buteomont/Delivery-Box-Reporter-LoRa/resources/Presentation/VL53L0X.jpg

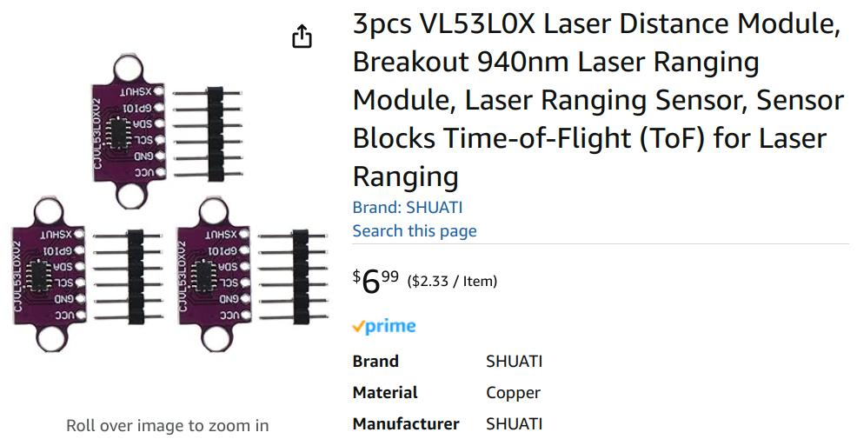
resources/Presentation/VL53L0X.jpg
