buteomont/Delivery-Box-Reporter-LoRa/resources/Presentation/TP4056 Battery Manager.png

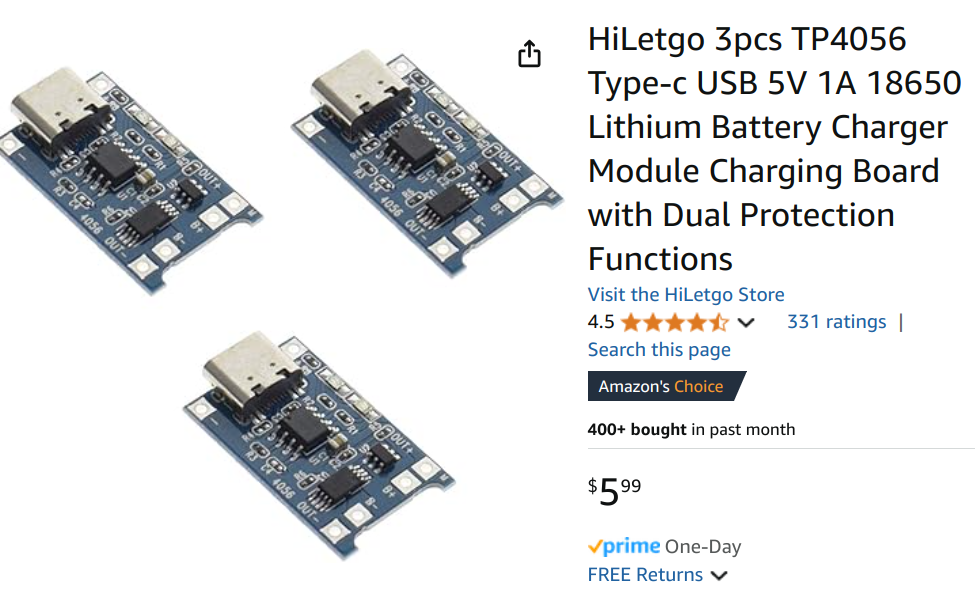
resources/Presentation/TP4056 Battery Manager.png
