buteomont/Delivery-Box-Reporter-LoRa/resources/Presentation/box in snow.png

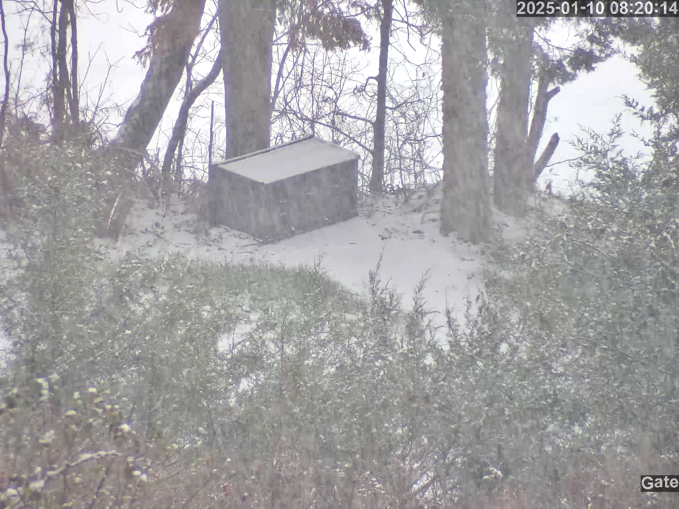
resources/Presentation/box in snow.png
