buteomont/Delivery-Box-Reporter-LoRa/resources/Presentation/display.jpg

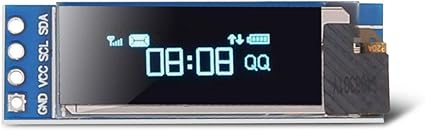
resources/Presentation/display.jpg
