buteomont/Delivery-Box-Reporter-LoRa/resources/Presentation/ESP-D1-Mini.jpg

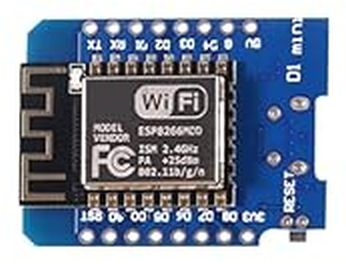
resources/Presentation/ESP-D1-Mini.jpg
