buteomont/Delivery-Box-Reporter-LoRa/resources/Presentation/HCSR04.png

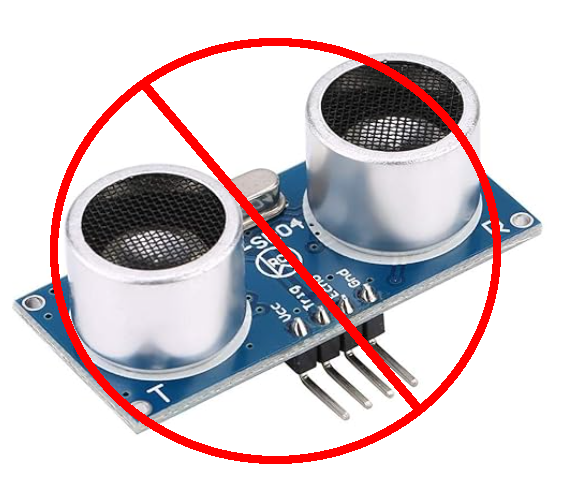
resources/Presentation/HCSR04.png
