buteomont/Delivery-Box-Reporter-LoRa/resources/Presentation/laser.jpg

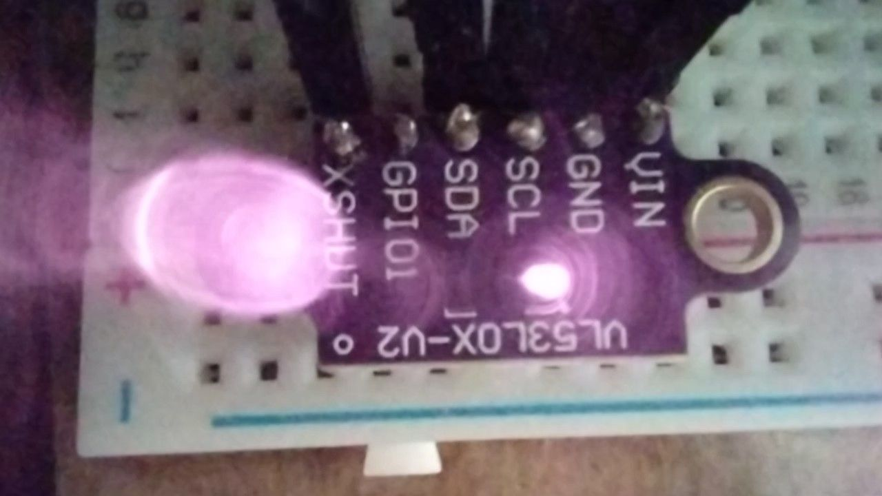
resources/Presentation/laser.jpg
