buteomont/Delivery-Box-Reporter-LoRa/resources/Presentation/LoRa to MQTT converter.png

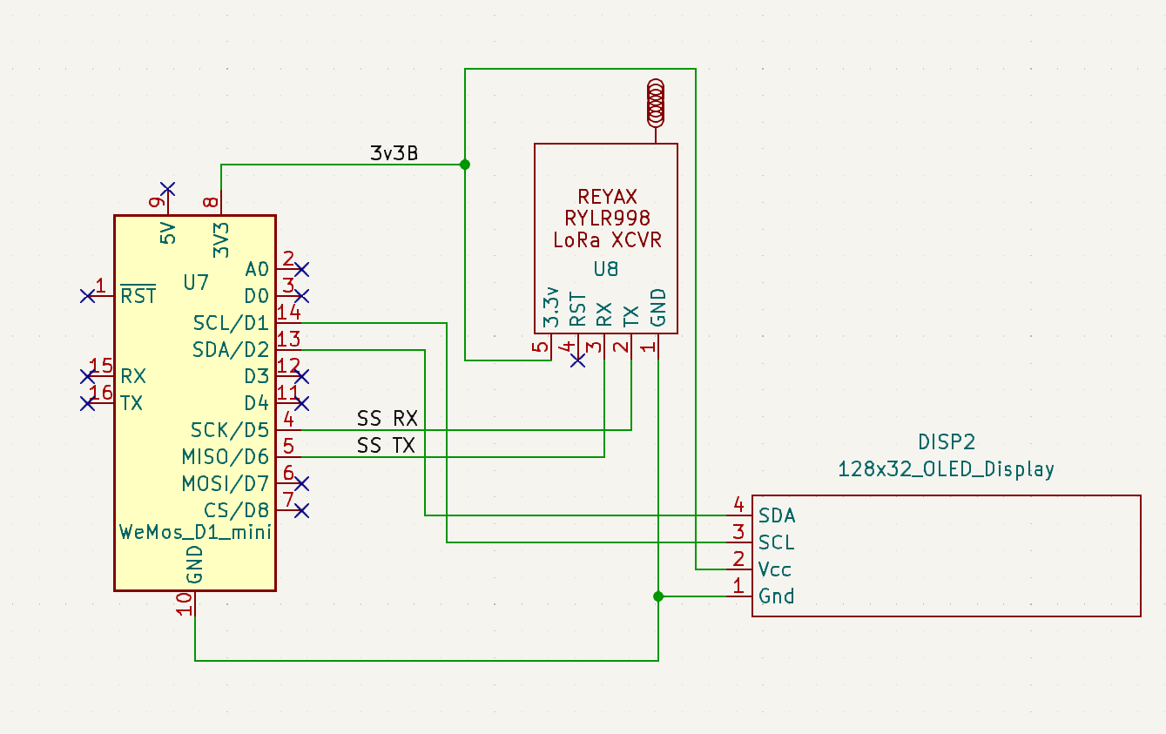
resources/Presentation/LoRa to MQTT converter.png
