buteomont/Delivery-Box-Reporter-LoRa/resources/Presentation/new water line view labelled.jpg

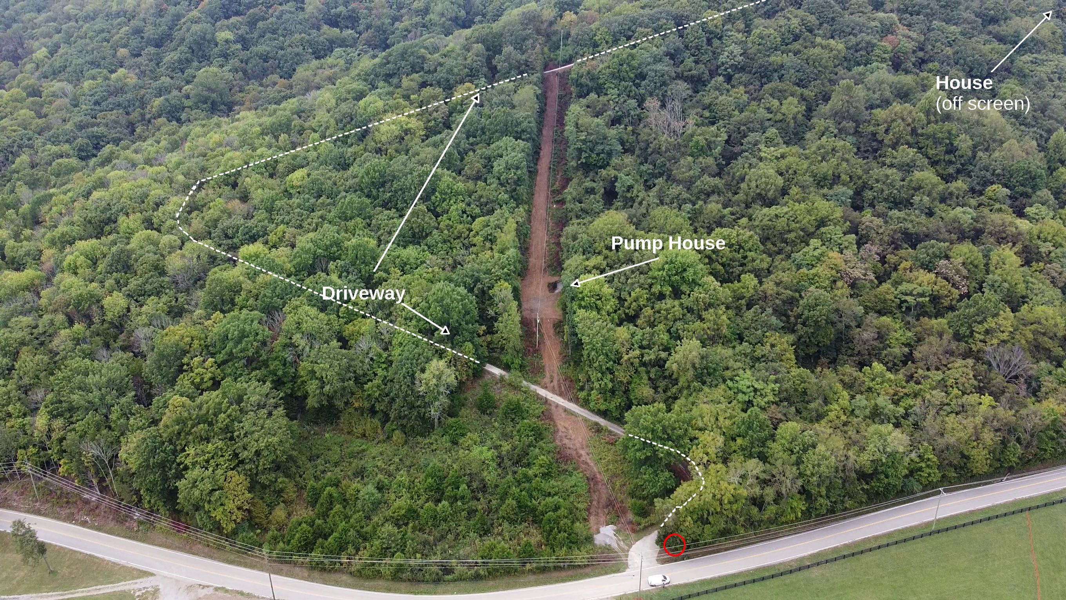
resources/Presentation/new water line view labelled.jpg
