buteomont/Delivery-Box-Reporter-LoRa/resources/Presentation/new water line view.jpg

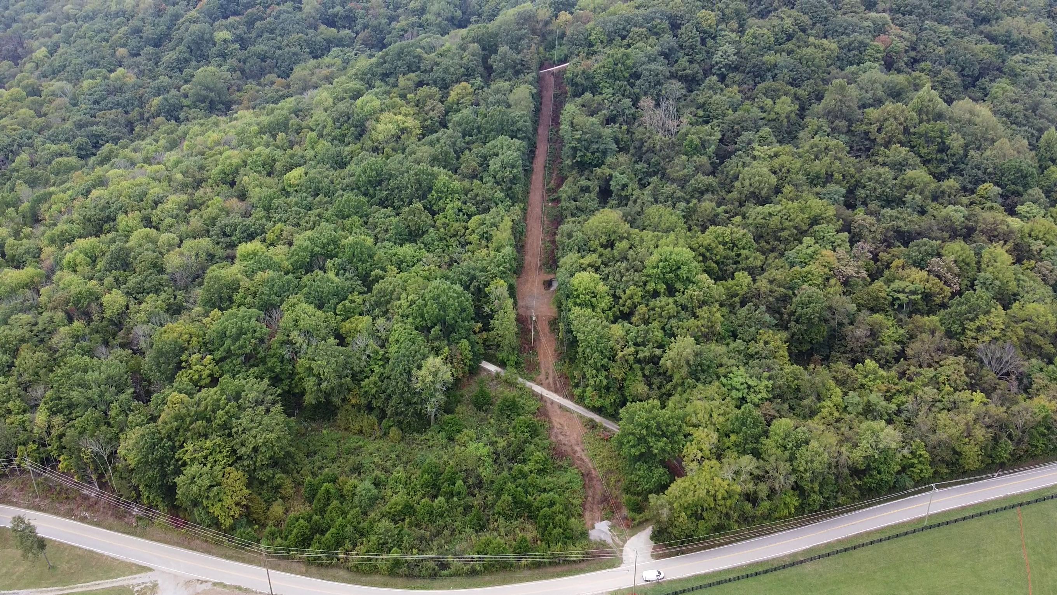
resources/Presentation/new water line view.jpg
