buteomont/Delivery-Box-Reporter-LoRa/resources/Presentation/pumphouse in snow.png

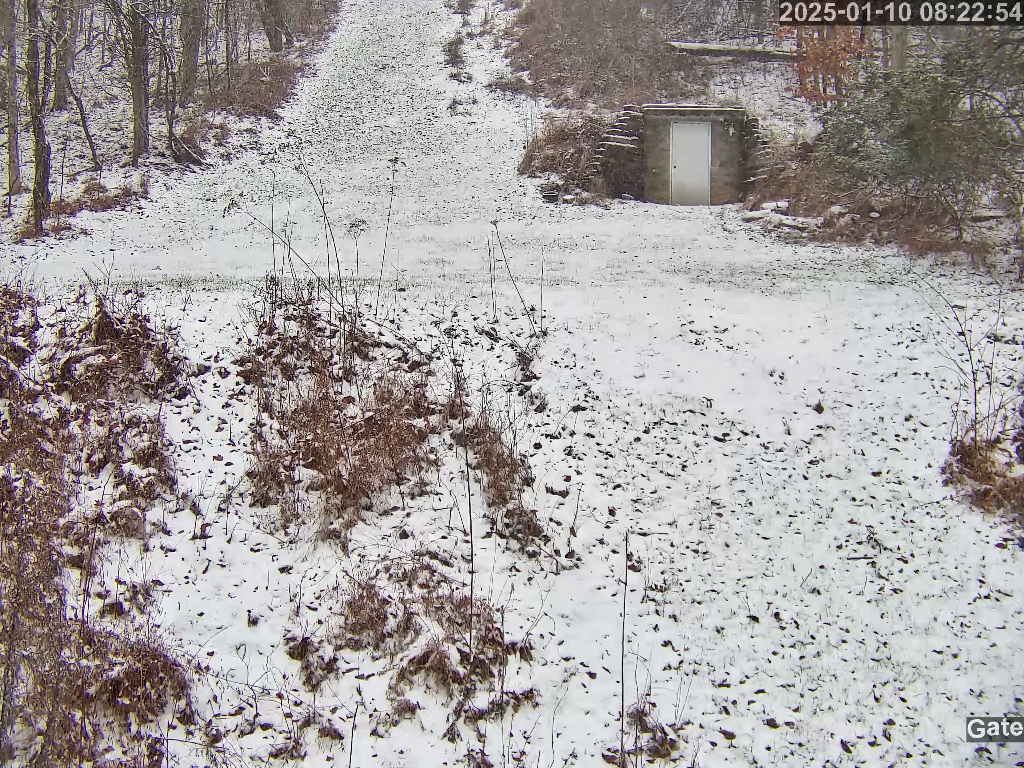
resources/Presentation/pumphouse in snow.png
