buteomont/Delivery-Box-Reporter-LoRa/resources/Presentation/receiver.jpg

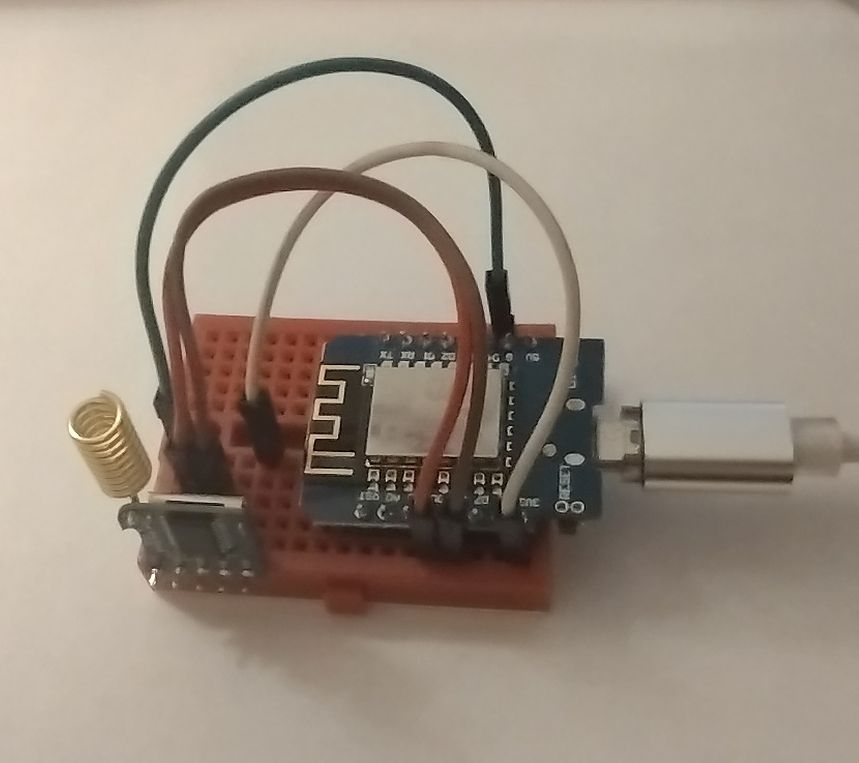
resources/Presentation/receiver.jpg
