buteomont/Delivery-Box-Reporter-LoRa/resources/Presentation/RYLR998.jpg

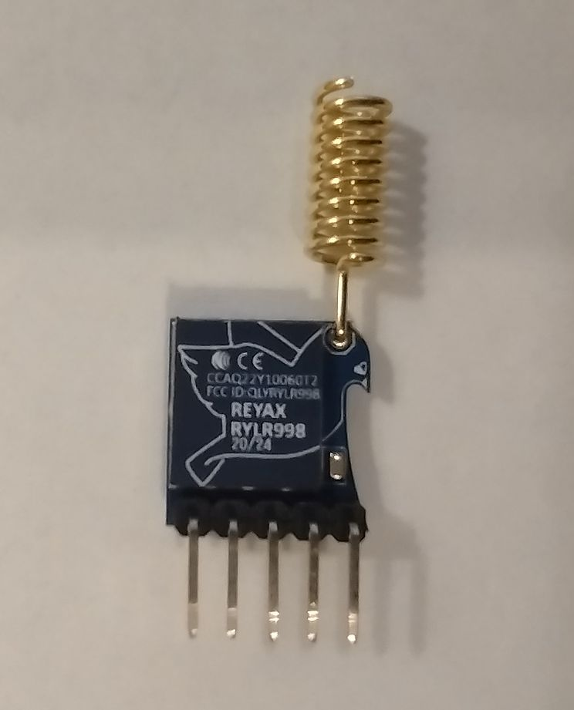
resources/Presentation/RYLR998.jpg
