buteomont/Delivery-Box-Reporter-LoRa/resources/Presentation/Schematic Full Sensor.png

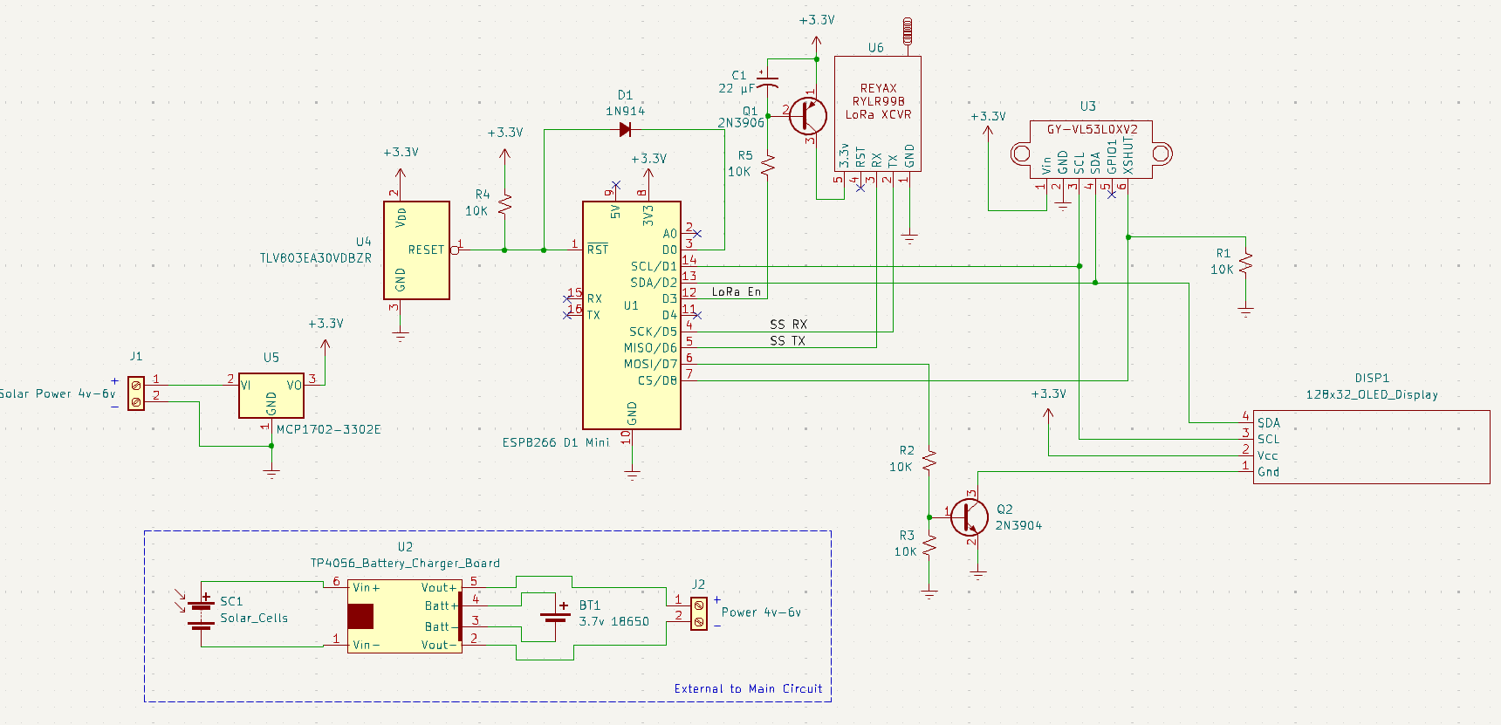
resources/Presentation/Schematic Full Sensor.png
