buteomont/Delivery-Box-Reporter-LoRa/resources/Presentation/Schematic Main zoom.png

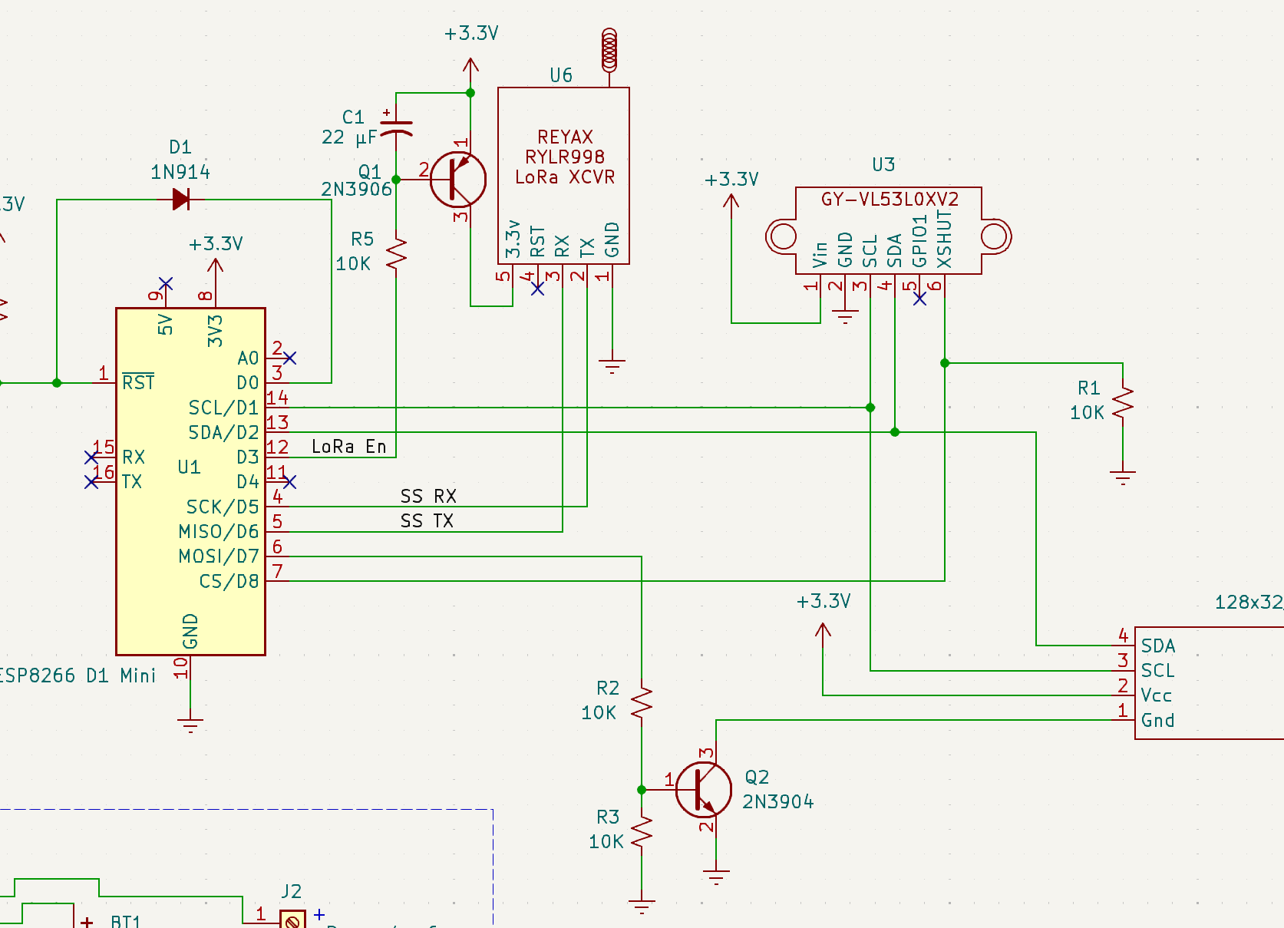
resources/Presentation/Schematic Main zoom.png
