buteomont/Delivery-Box-Reporter-LoRa/resources/Presentation/Schematic-receiver.jpg

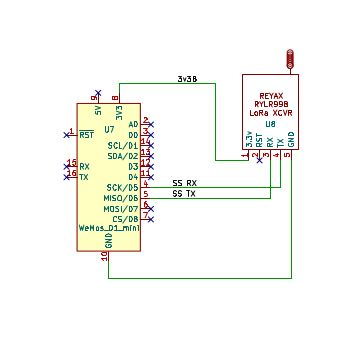
resources/Presentation/Schematic-receiver.jpg
