buteomont/Delivery-Box-Reporter-LoRa/resources/Presentation/Schematic-receiver.png

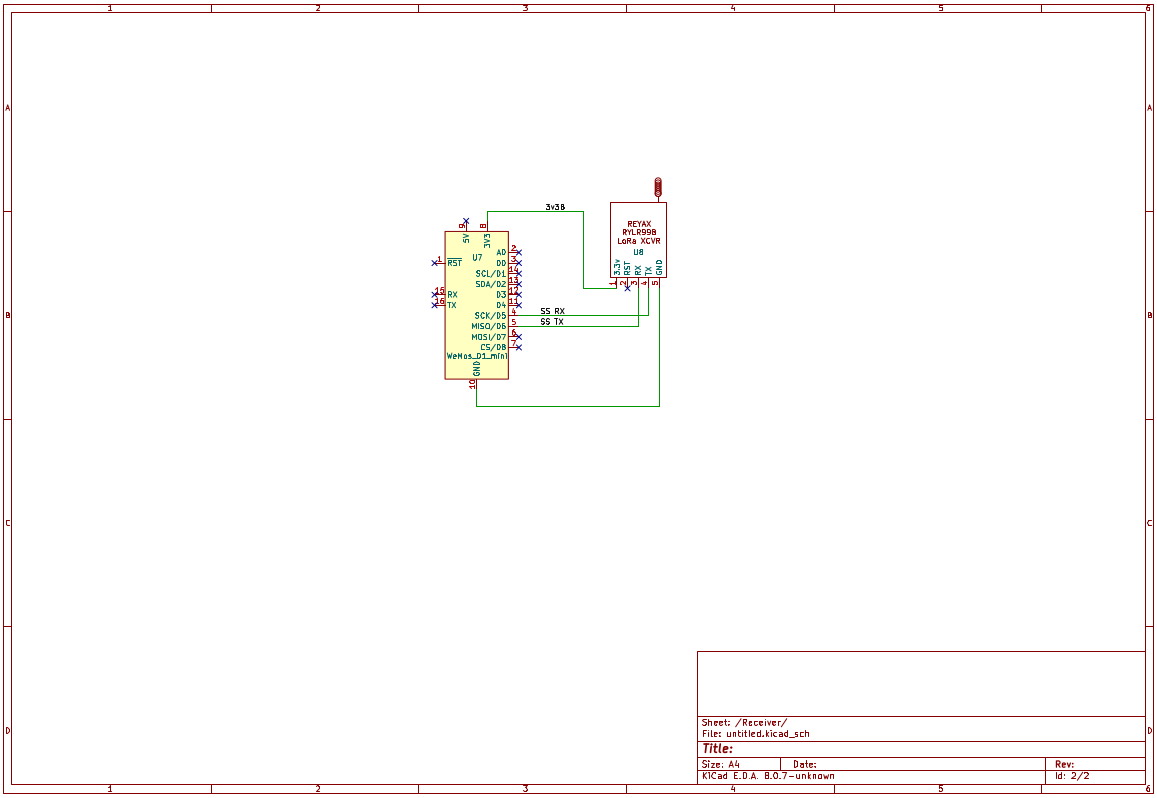
resources/Presentation/Schematic-receiver.png
