buteomont/Delivery-Box-Reporter-LoRa/resources/Presentation/Schematic-transmitter.jpg

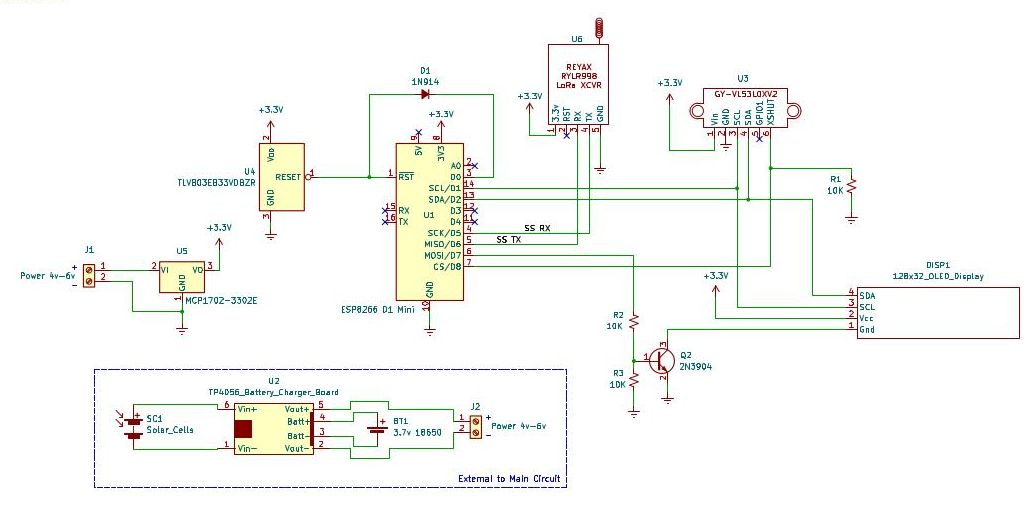
resources/Presentation/Schematic-transmitter.jpg
