buteomont/Delivery-Box-Reporter-LoRa/resources/Presentation/sensor closeup 2.png

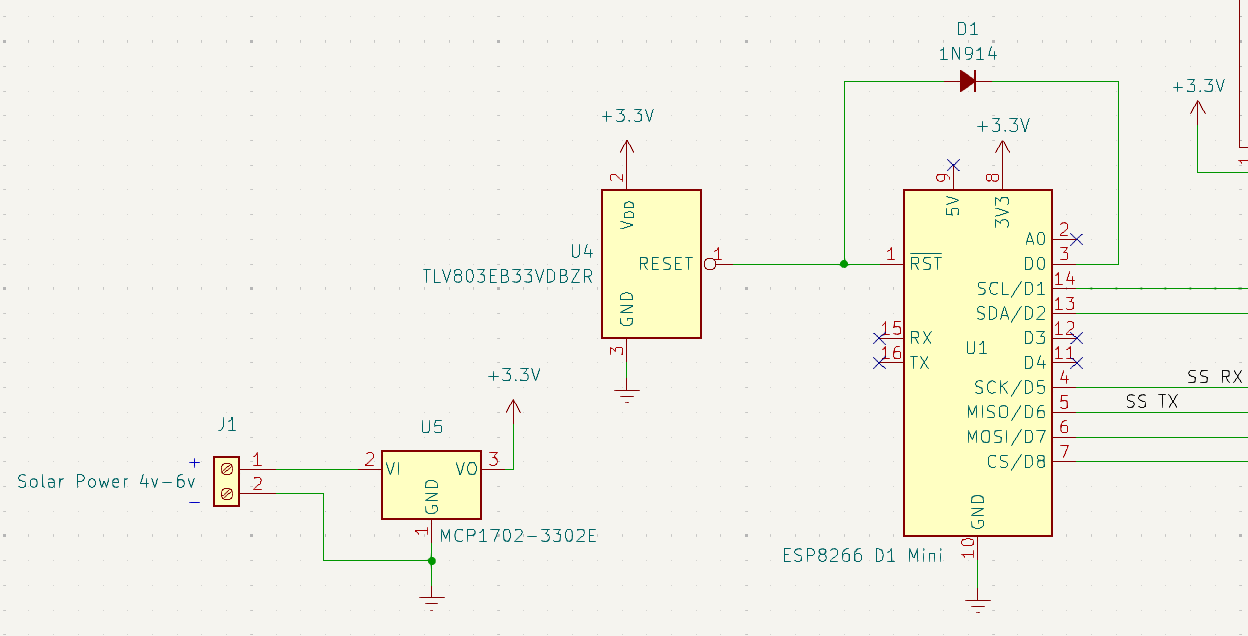
resources/Presentation/sensor closeup 2.png
