buteomont/Delivery-Box-Reporter-LoRa/resources/Presentation/sensor closeup.png

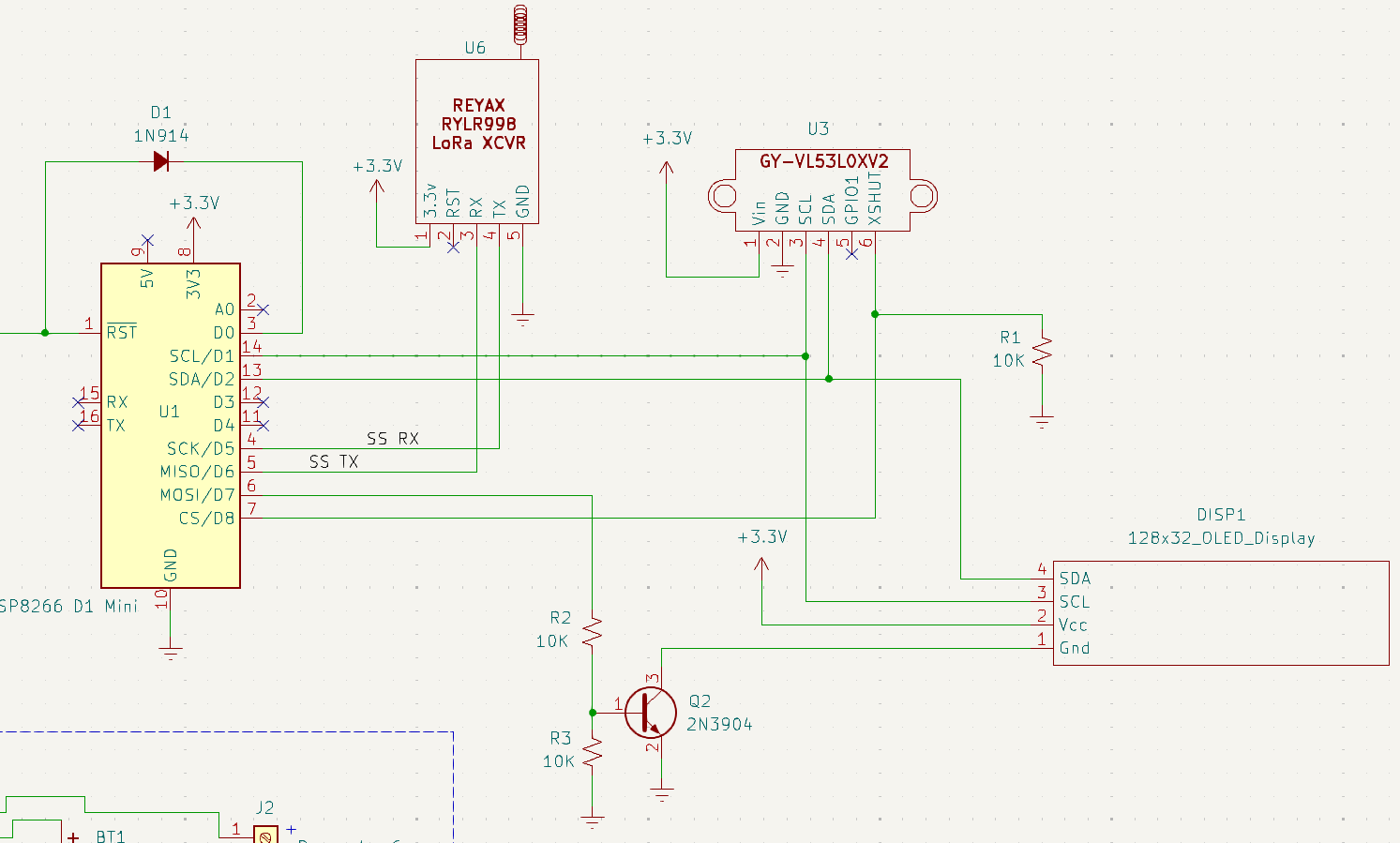
resources/Presentation/sensor closeup.png
