buteomont/Delivery-Box-Reporter-LoRa/resources/Presentation/snowy drive.jpg

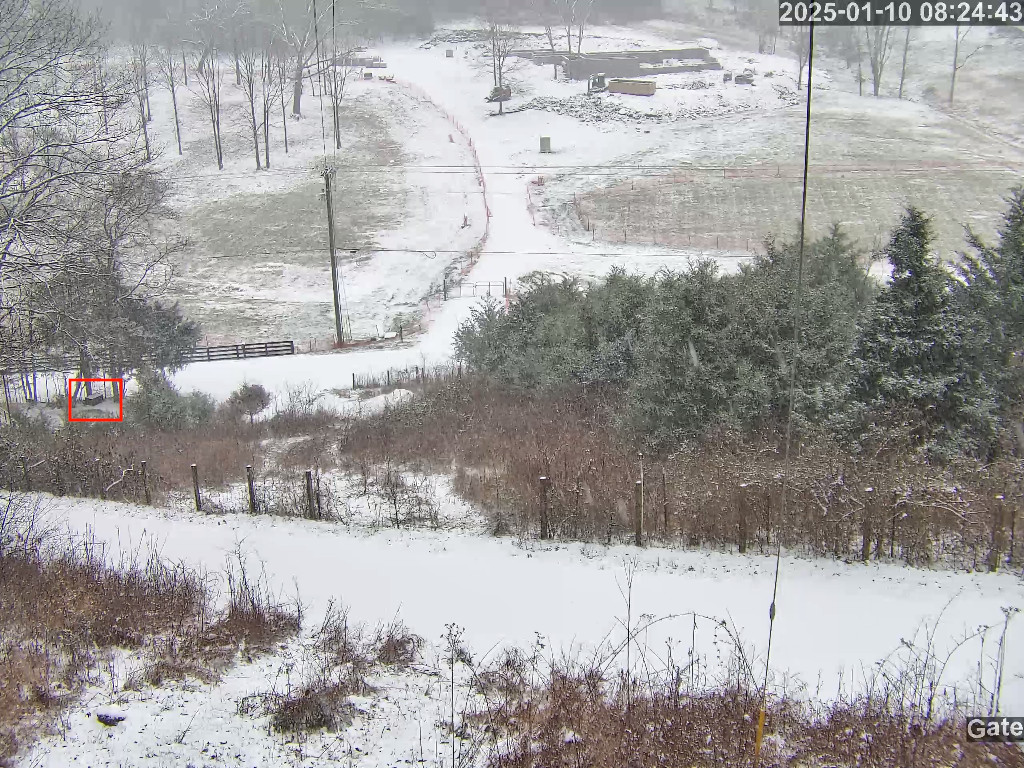
resources/Presentation/snowy drive.jpg
