buteomont/Delivery-Box-Reporter-LoRa/resources/Presentation/transmitter.jpg

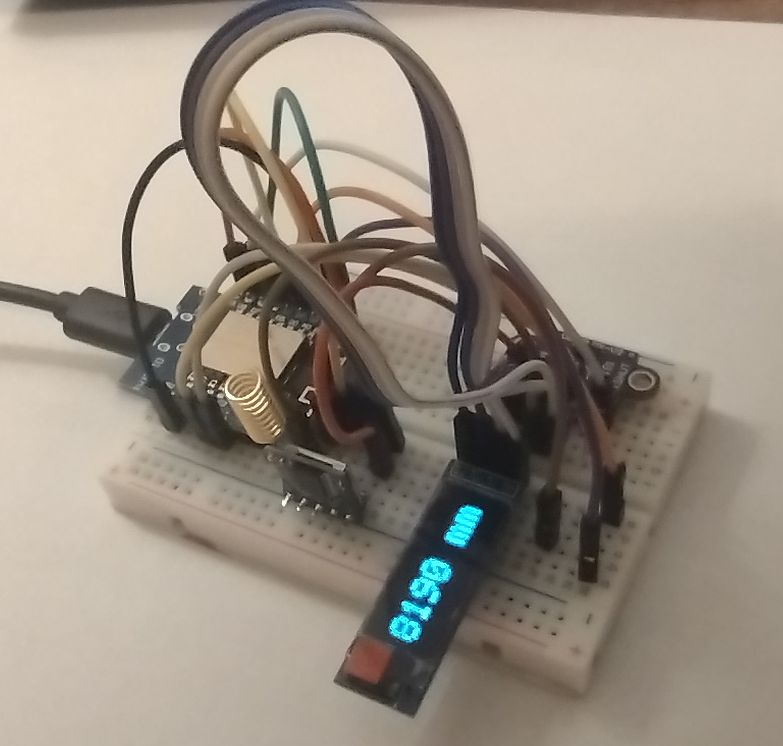
resources/Presentation/transmitter.jpg
