buteomont/Delivery-Box-Reporter-LoRa/resources/Presentation/VL53L0X cones.jpg

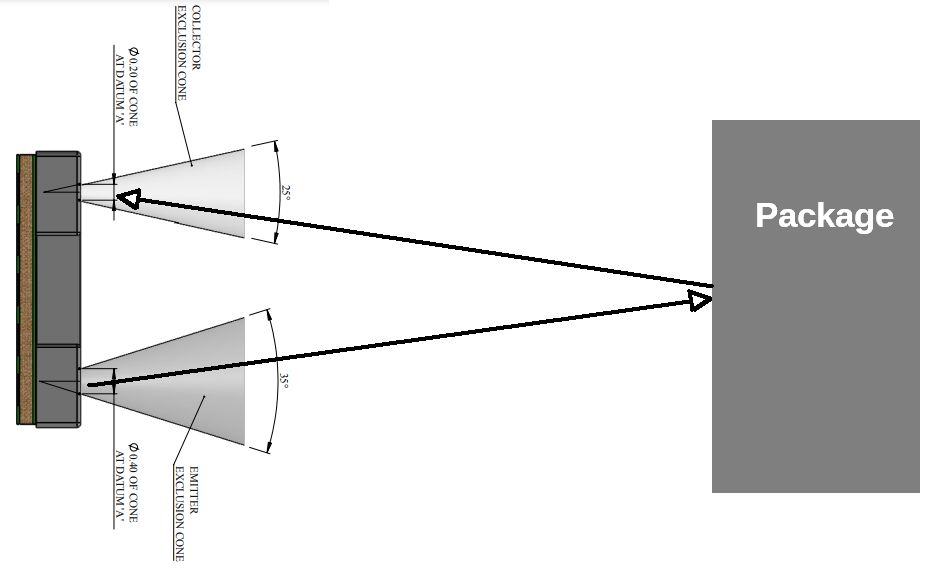
resources/Presentation/VL53L0X cones.jpg
