buteomont/Delivery-Box-Reporter-LoRa/resources/Presentation/VL53L0X cones.png

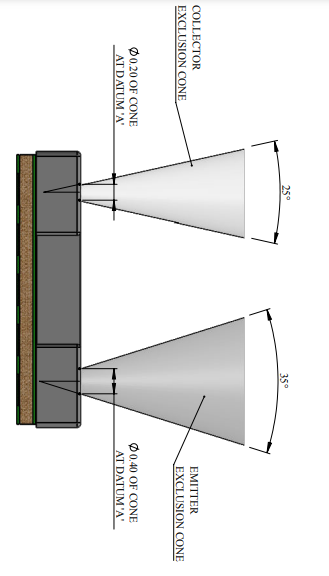
resources/Presentation/VL53L0X cones.png
