buteomont/Delivery-Box-Reporter-LoRa/resources/Presentation/VL53L0X-single.jpg

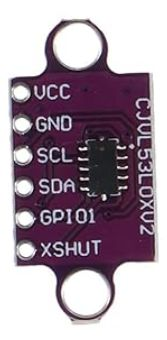
resources/Presentation/VL53L0X-single.jpg
