buteomont/Delivery-Box-Reporter-LoRa/resources/Presentation/VL53L0X.png

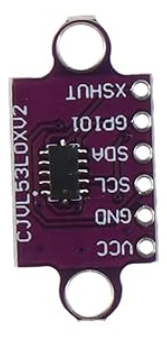
resources/Presentation/VL53L0X.png
