buteomont/Delivery-Box-Reporter-LoRa/resources/FreeCAD/DeliveryBoxReporter with LoRa-Bottom.stl

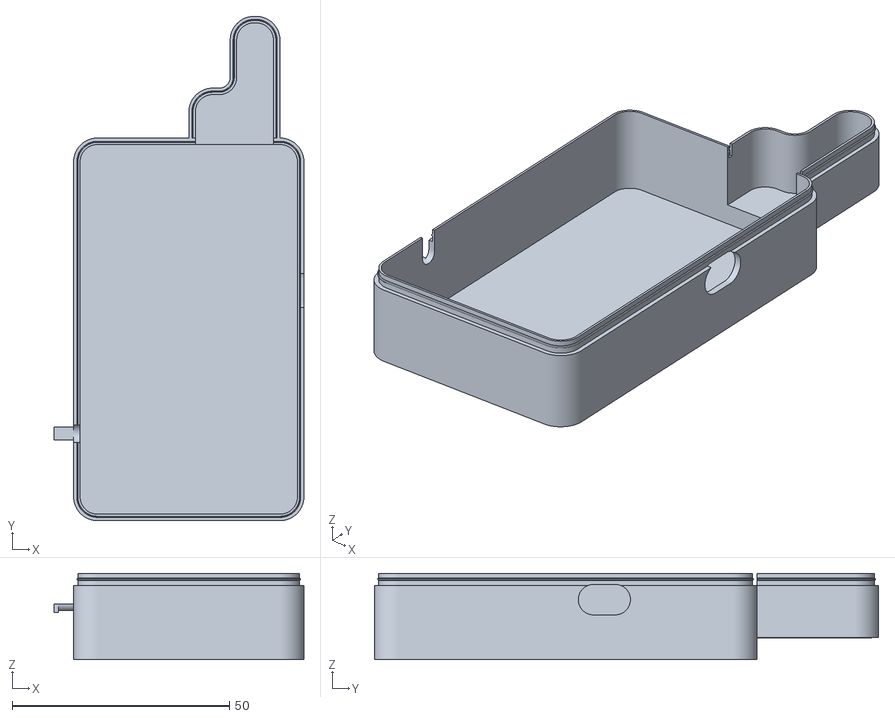
[picture p27: CAD file, 2025-03-05]
resources/FreeCAD/DeliveryBoxReporter with LoRa-Bottom.stl
57.5 x 116.0 x 19.9
