buteomont/Delivery-Box-Reporter-LoRa/resources/FreeCAD/Dual Solar Panel with 18650 and BMS/solar panel holder.FCStd

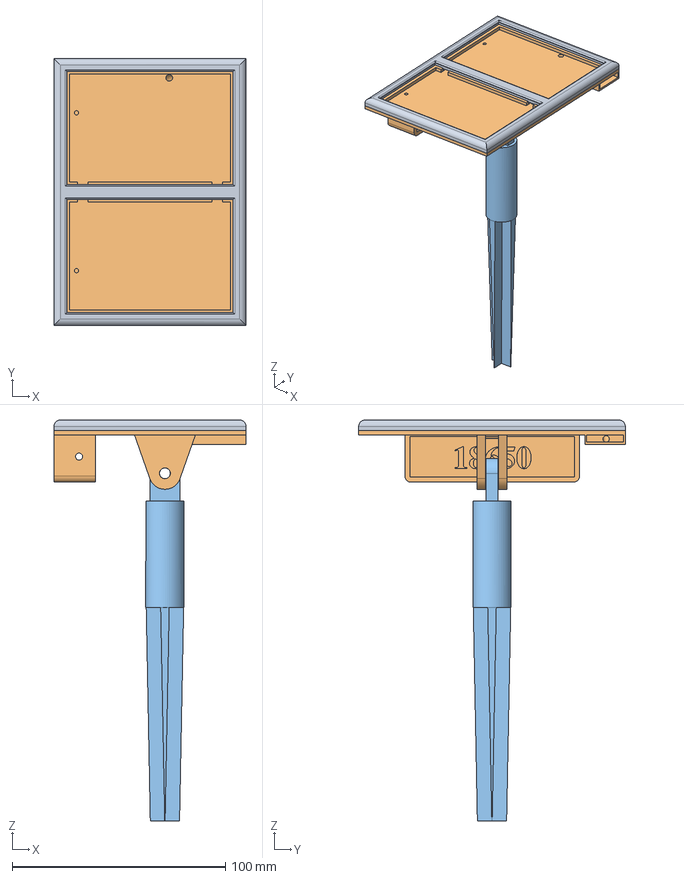
[picture p28: CAD file, 2025-02-05]
resources/FreeCAD/Dual Solar Panel with 18650 and BMS/solar panel holder.FCStd
90.0 x 125.0 x 188.0 mm
FrontBody
BackBody
StakeBody
