buteomont/Delivery-Box-Reporter-LoRa/resources/FreeCAD/Dual Solar Panel with 18650 and BMS/solar panel holder-Stake.stl

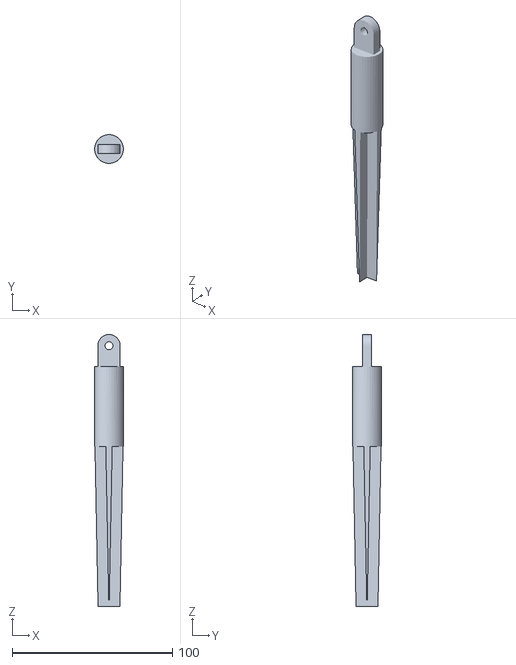
[picture p29: CAD file, 2025-02-05]
resources/FreeCAD/Dual Solar Panel with 18650 and BMS/solar panel holder-Stake.stl
18.0 x 18.0 x 170.0
