buteomont/Delivery-Box-Reporter-LoRa/resources/FreeCAD/LoRa-to-MQTT-Translator-Top.stl

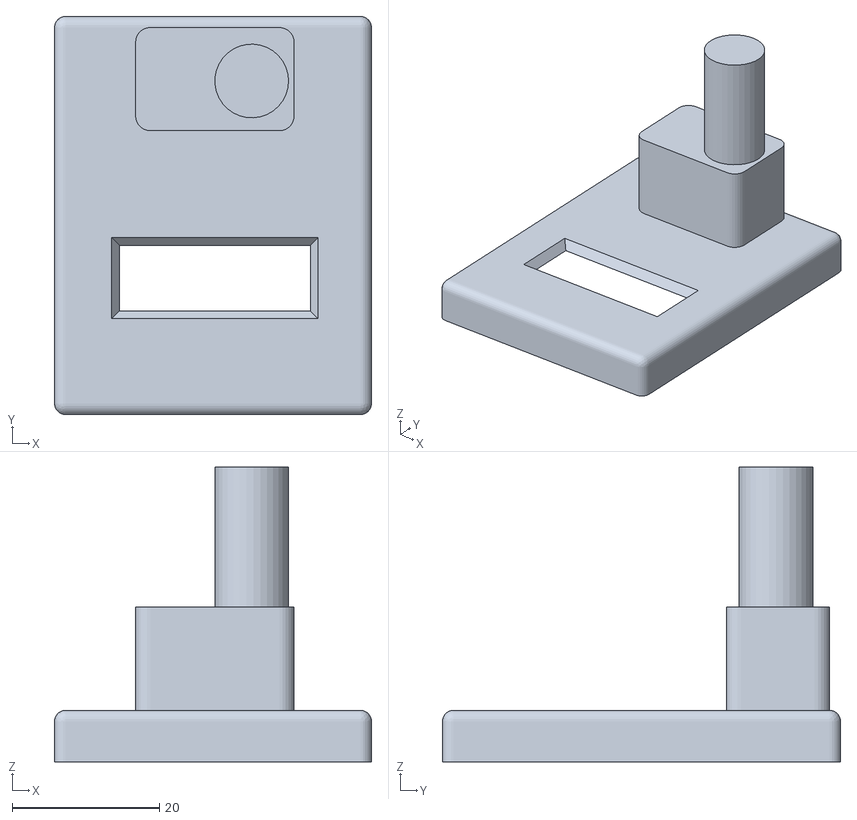
[picture p30: CAD file, 2025-03-05]
resources/FreeCAD/LoRa-to-MQTT-Translator-Top.stl
43.0 x 54.0 x 40.0
