buteomont/Delivery-Box-Reporter-LoRa/resources/FreeCAD/Dual Solar Panel with 18650 and BMS/double solar panel frame.stl

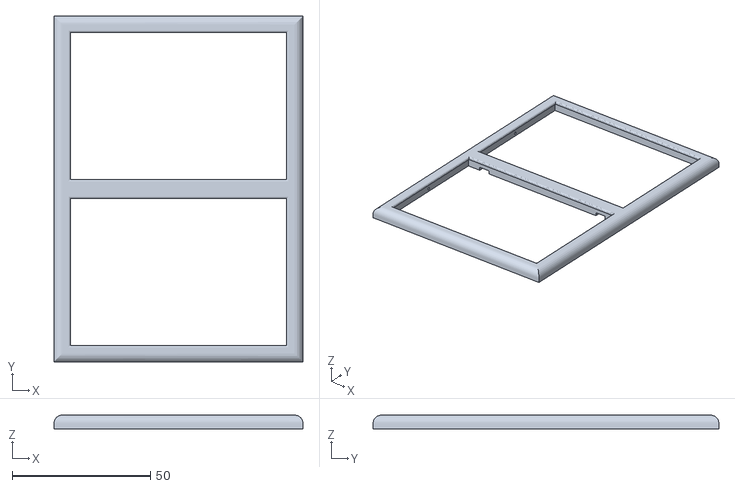
[picture p31: CAD file, 2025-02-05]
resources/FreeCAD/Dual Solar Panel with 18650 and BMS/double solar panel frame.stl
90.0 x 125.0 x 5.00
