buteomont/Delivery-Box-Reporter-LoRa/resources/FreeCAD/LoRa-to-MQTT-Translator-Bottom.stl

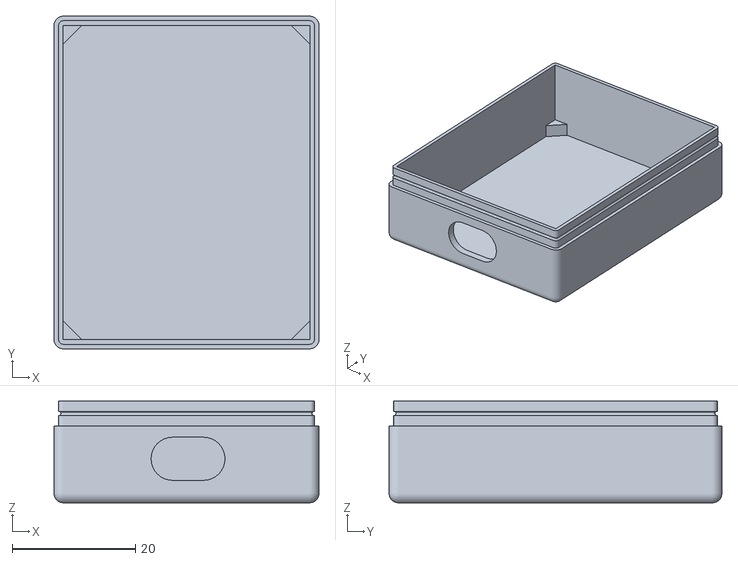
[picture p32: CAD file, 2025-03-05]
resources/FreeCAD/LoRa-to-MQTT-Translator-Bottom.stl
43.0 x 54.0 x 16.5
