buteomont/Delivery-Box-Reporter-LoRa/resources/FreeCAD/displayHolder.FCStd

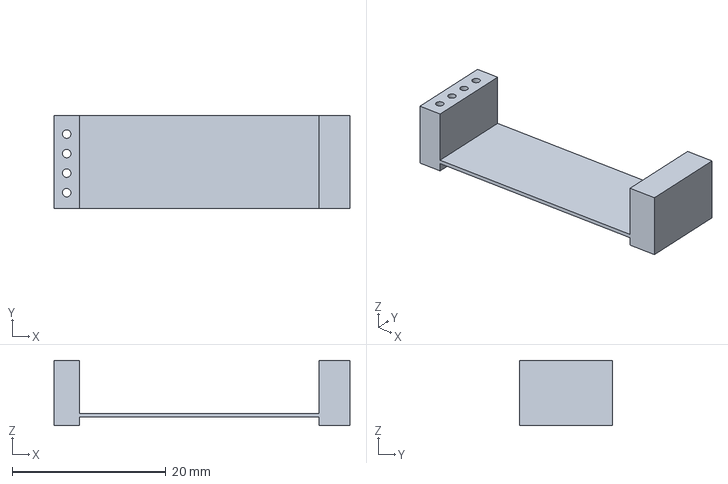
[picture p33: CAD file, 2025-03-05]
resources/FreeCAD/displayHolder.FCStd
38.5 x 12.1 x 8.50 mm
