buteomont/Delivery-Box-Reporter-LoRa/resources/FreeCAD/Dual Solar Panel with 18650 and BMS/double solar panel back.stl

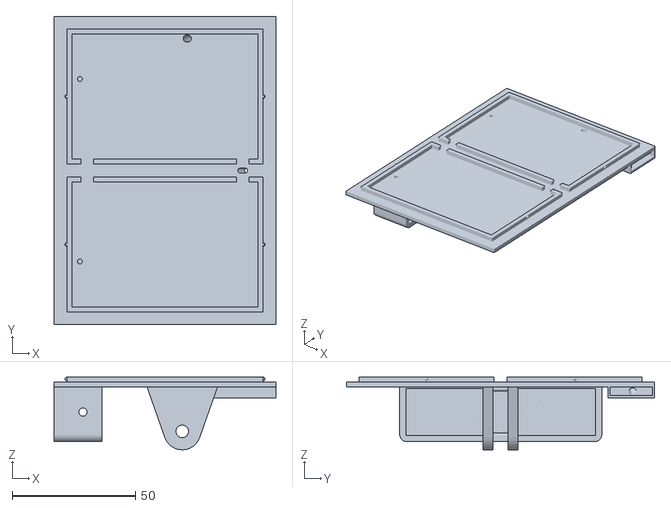
[picture p34: CAD file, 2025-02-05]
resources/FreeCAD/Dual Solar Panel with 18650 and BMS/double solar panel back.stl
90.0 x 125.0 x 29.5
