buteomont/Delivery-Box-Reporter-LoRa/resources/FreeCAD/LoRa-to-MQTT-disp-Top.stl

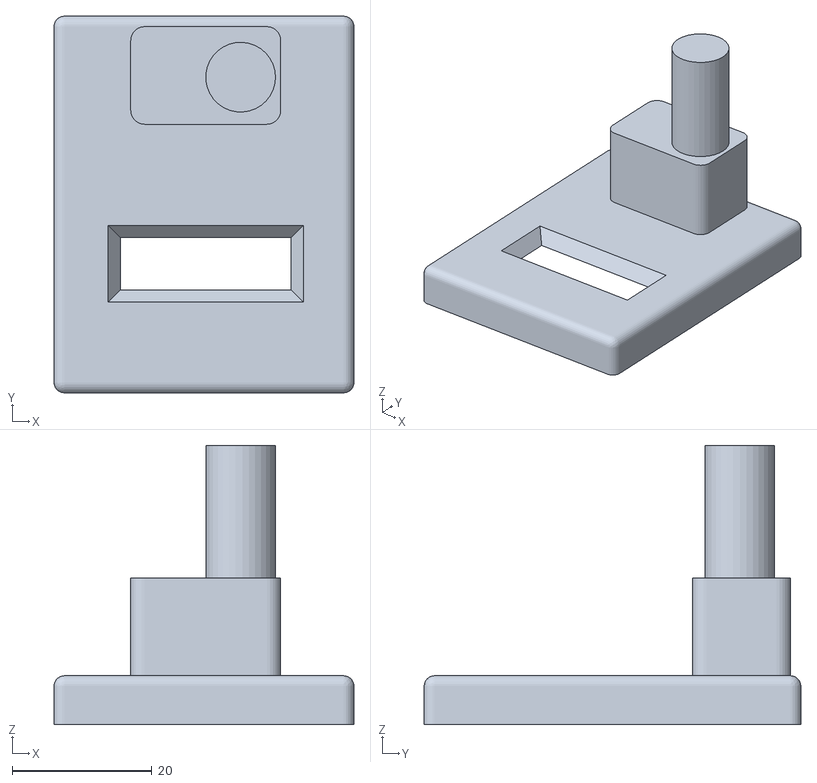
[picture p35: CAD file, 2025-02-14]
resources/FreeCAD/LoRa-to-MQTT-disp-Top.stl
43.0 x 54.0 x 40.0
