buteomont/Delivery-Box-Reporter-LoRa/resources/FreeCAD/DeliveryBoxReporter with LoRa-Left-Top.stl

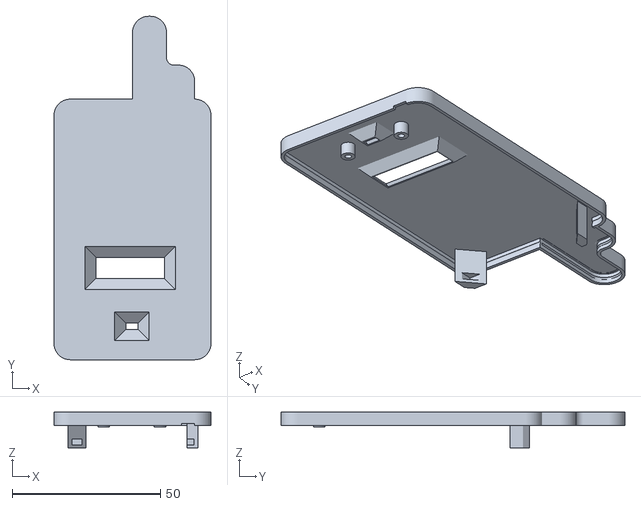
[picture p36: CAD file, 2025-02-11]
resources/FreeCAD/DeliveryBoxReporter with LoRa-Left-Top.stl
53.0 x 116.0 x 12.0
