buteomont/Delivery-Box-Reporter-LoRa/resources/FreeCAD/deliveryboxreporterlora.3mf

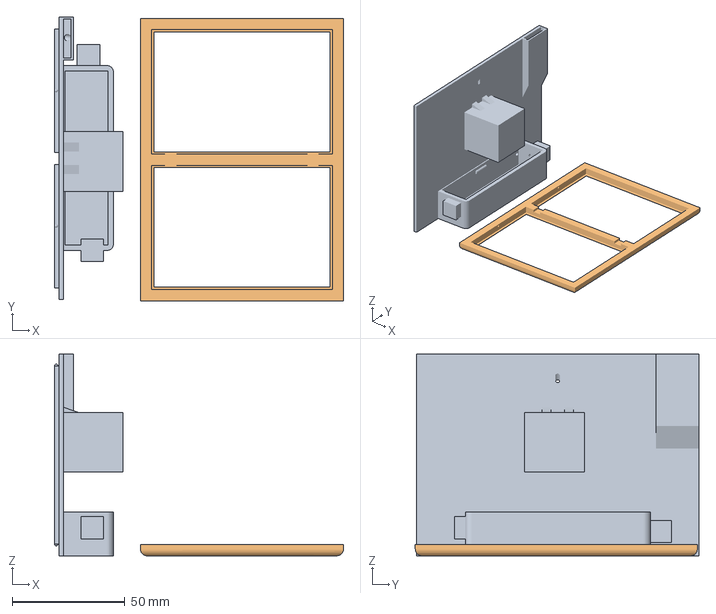
[picture p37: CAD file, 2025-02-05]
resources/FreeCAD/deliveryboxreporterlora.3mf
128.1 x 125.6 x 89.4 mm
double solar panel back.stl
double solar panel frame.stl
