buteomont/Delivery-Box-Reporter-LoRa/resources/FreeCAD/DeliveryBoxReporter-Top.stl

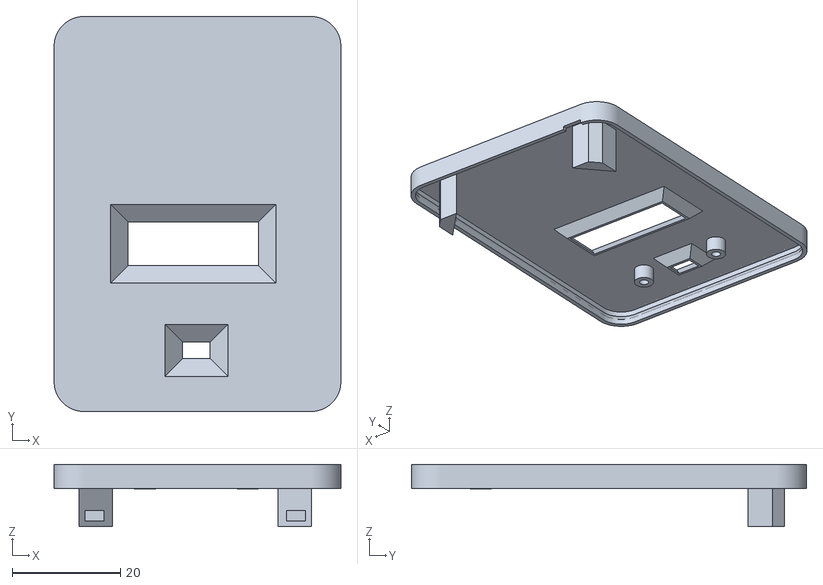
[picture p38: CAD file, 2025-01-14]
resources/FreeCAD/DeliveryBoxReporter-Top.stl
53.0 x 73.0 x 11.5
