buteomont/Delivery-Box-Reporter-LoRa/resources/FreeCAD/sensorShim.FCStd

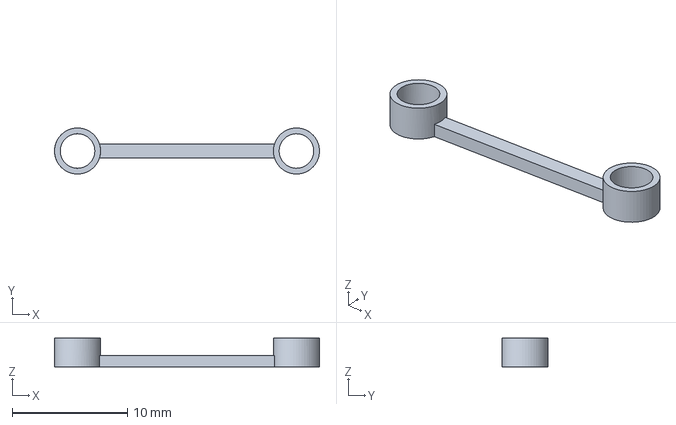
[picture p39: CAD file, 2025-01-14]
resources/FreeCAD/sensorShim.FCStd
23.0 x 4.00 x 2.50 mm
