buteomont/Delivery-Box-Reporter-LoRa/resources/FreeCAD/DeliveryBoxReporter-Bottom.stl

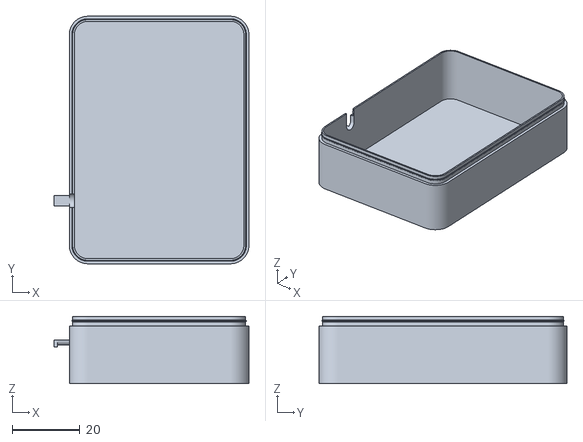
[picture p40: CAD file, 2025-01-14]
resources/FreeCAD/DeliveryBoxReporter-Bottom.stl
57.5 x 73.0 x 19.9
