buteomont/Delivery-Box-Reporter-LoRa/resources/FreeCAD/displayShim.FCStd

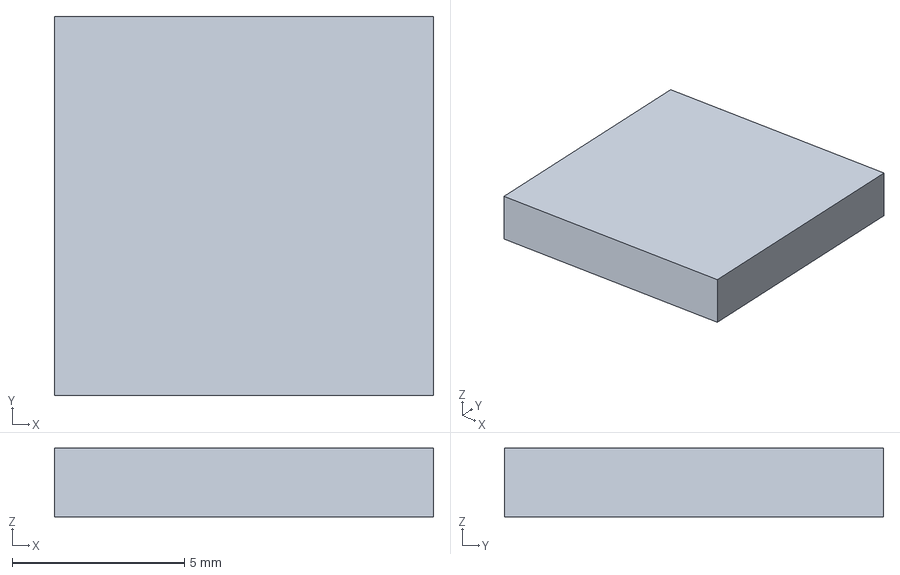
[picture p41: CAD file, 2025-01-14]
resources/FreeCAD/displayShim.FCStd
11.0 x 11.0 x 2.00 mm
