buteomont/Delivery-Box-Reporter-LoRa/resources/FreeCAD/DeliveryBoxReporter (copy).FCStd

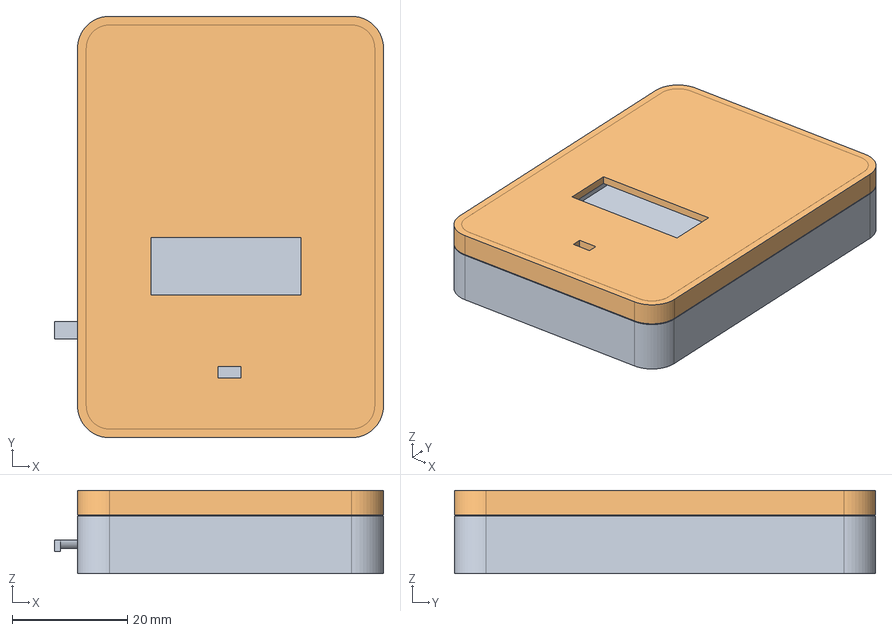
[picture p42: CAD file, 2025-01-14]
resources/FreeCAD/DeliveryBoxReporter (copy).FCStd
57.0 x 73.0 x 14.5 mm
BottomBody
TopBody
