buteomont/Delivery-Box-Reporter-LoRa/(list of files, cad)

Other CAD files:
resources/FreeCAD/DeliveryBoxReporter with LoRa-Left-Bottom.stl
resources/FreeCAD/LoRa-to-MQTT-disp-Bottom.stl
resources/FreeCAD/DeliveryBoxReporter with LoRa-Top.stl
resources/FreeCAD/DeliveryBoxReporter-top.stl
resources/FreeCAD/displayHolder.stl
resources/FreeCAD/displayShim.stl
resources/FreeCAD/sensorShim.stl
