buteomont/Delivery-Box-Reporter-LoRa/resources/kicad/delivery-box-reporter-lora/delivery-box-reporter-lora.kicad_pcb

## KiCad design resources/kicad/delivery-box-reporter-lora/delivery-box-reporter-lora.kicad_pcb (2025-03-05)

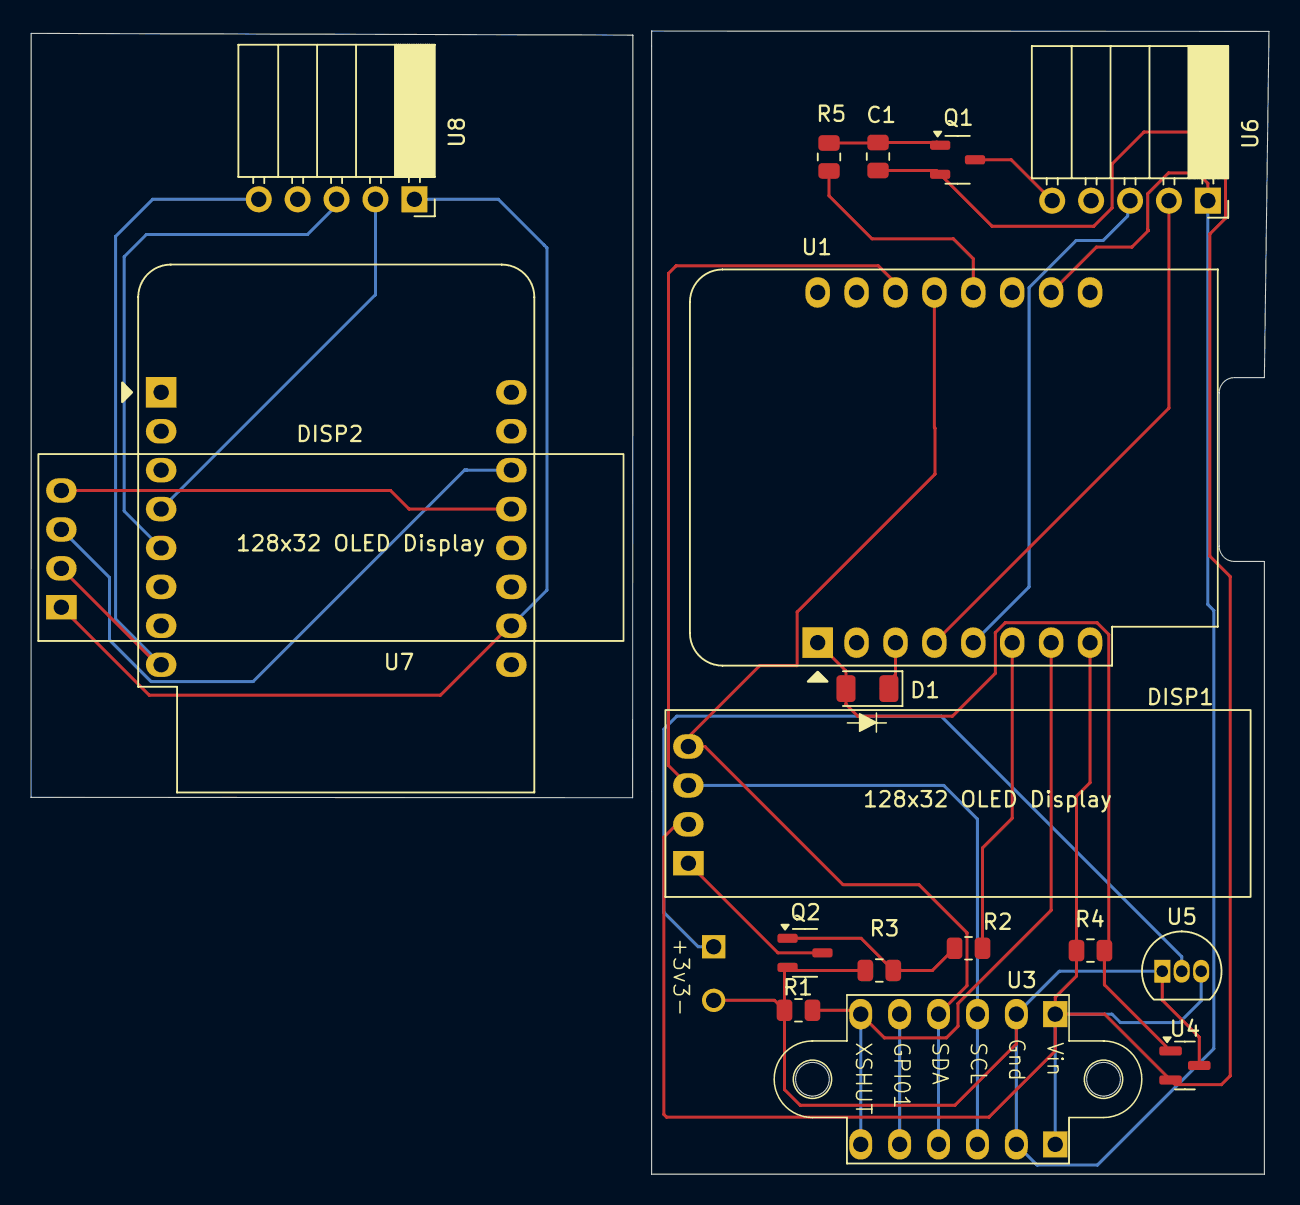
[picture p43: board delivery-box-reporter-lora.kicad_pcb from above]

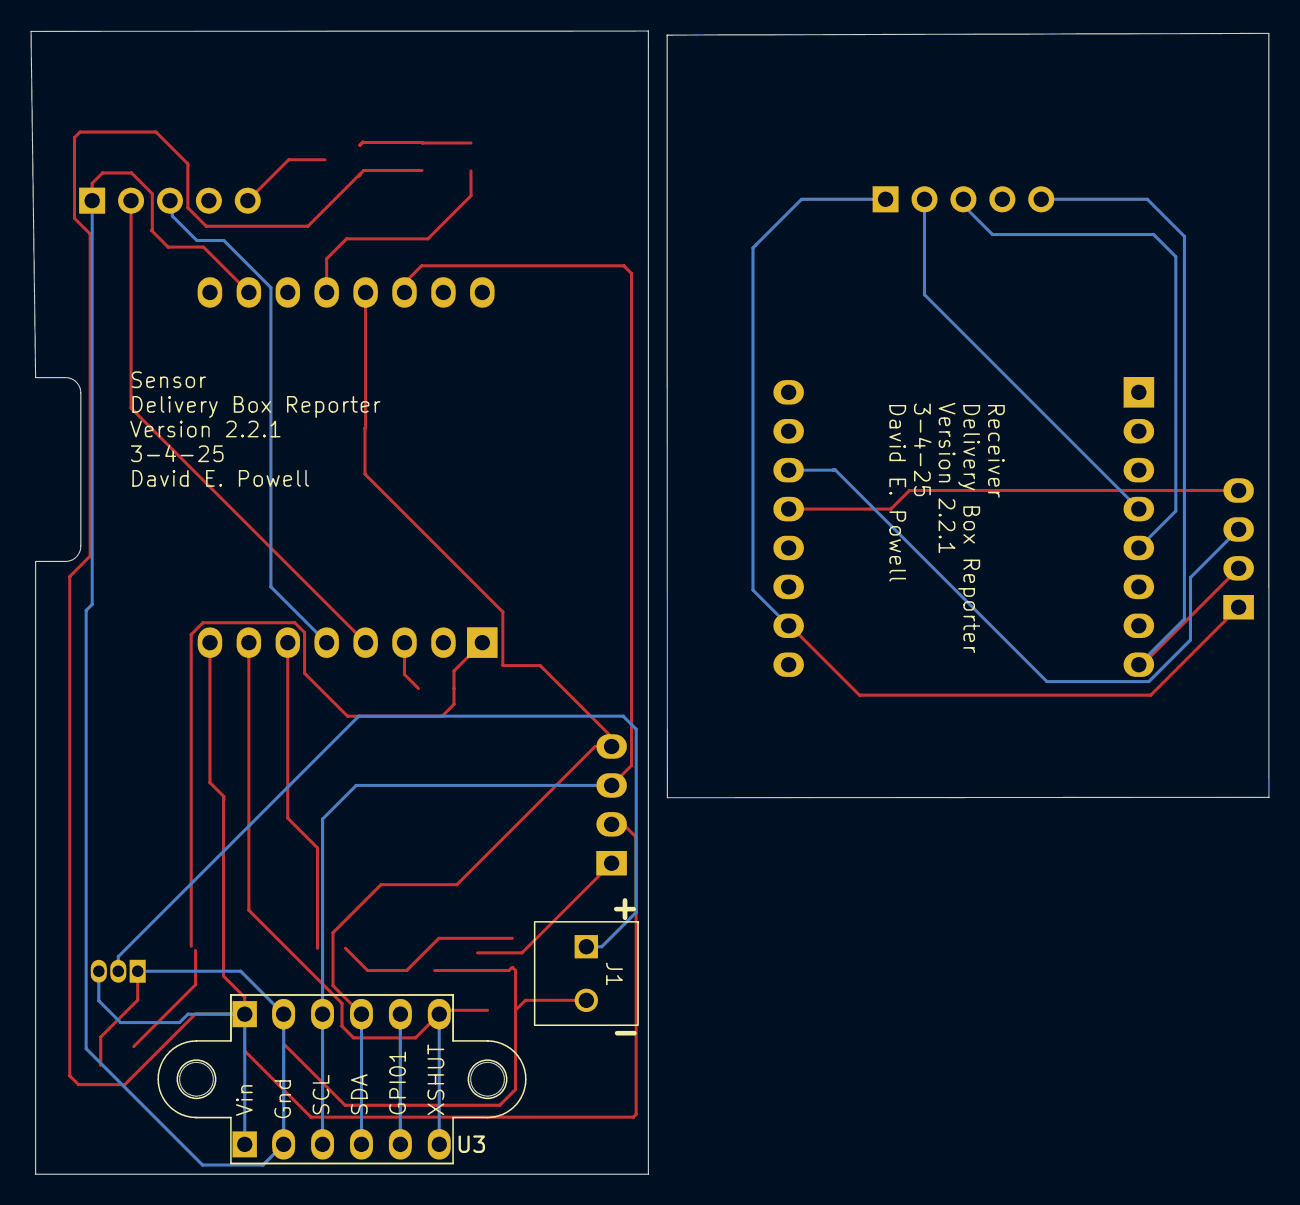
[picture p44: board delivery-box-reporter-lora.kicad_pcb from below]

Board: 2 copper layers, 80.8 x 74.6 mm, 20 parts (2 on the bottom side), 22 nets.

Parts:
C1: 22 μF; R_0805_2012Metric
D1: 1N914; D_1206_3216Metric
DISP1, DISP2: 128x32_OLED_Display; OLED_0.91_128x32
J1: Solar Power 4v-6v; KF350 2 Pin Terminal Block
Q1: 2N3906; MMBT3904-7-F_SOT-23-3
Q2: 2N3904; MMBT3904-7-F_SOT-23-3
R1, R2, R3, R4: 10K; R_0805_2012Metric
R5: 1K; R_0805_2012Metric
U1: ESP8266 D1 Mini; WEMOS_D1_mini_light
U3, U3#2: GY-VL53LOX-V2 Distance Sensor
U4: TLV803EA30VDBZR; SOT-23
U5: MCP1702-3302E; TO-92_Inline
U6, U8: PinSocket_1x05_P2.54mm_Horizontal
U7: WeMos_D1_mini; WEMOS_D1_mini_light

Connections:
+3.3V: C1.1, DISP1.2 (Vcc), Q1.2 (E), R4.2, U1.8 (3V3), U3.1 (Vin), U3#2.1 (Vin), U4.2 (V_{DD}), U5.3 (VO)
/LoRa En: R5.1, U1.12 (D3)
/Receiver/3v3B: DISP2.2 (Vcc), U7.8 (3V3), U8.5 (3.3v)
/Receiver/SS RX: U7.4 (SCK/D5), U8.2 (TX)
/Receiver/SS TX: U7.5 (MISO/D6), U8.3 (RX)
/SS RX: U1.4 (SCK/D5), U6.2 (TX)
/SS TX: U1.5 (MISO/D6), U6.3 (RX)
Earth: J1.2, Q2.2 (E), R1.1, R3.1, U1.10 (GND), U3.2 (GND), U3#2.2 (GND), U4.3 (GND), U5.1 (GND), U6.1 (GND)
unnamed: D1.2 (A), R4.1, U1.1 (~RST), U4.1 (RESET)
unnamed: D1.1 (K), U1.3 (D0)
unnamed: DISP1.1 (Gnd), Q2.3 (C)
unnamed: DISP1.3 (SCL), U1.14 (SCL/D1), U3.3 (SCL), U3#2.3 (SCL)
unnamed: DISP1.4 (SDA), U1.13 (SDA/D2), U3.4 (SDA), U3#2.4 (SDA)
unnamed: DISP2.1 (Gnd), U7.10 (GND), U8.1 (GND)
unnamed: DISP2.3 (SCL), U7.14 (SCL/D1)
unnamed: DISP2.4 (SDA), U7.13 (SDA/D2)
unnamed: J1.1, U5.2 (VI)
unnamed: C1.2, Q1.1 (B), R5.2
unnamed: Q1.3 (C), U6.5 (3.3v)
unnamed: Q2.1 (B), R2.1, R3.2
unnamed: R1.2, U1.7 (CS/D8), U3.6 (XSHUT), U3#2.6 (XSHUT)
unnamed: R2.2, U1.6 (MOSI/D7)
