buteomont/Delivery-Box-Reporter-LoRa/(commit log)

2025-01-15 Many updates and fixes
    [RYLR998.cpp, delivery_reporter_lora.h, main.cpp]
2025-01-15 Fixed several bugs in report()
    [RYLR998.cpp, RYLR998.h, main.cpp]
2025-01-18 Found the error that was causing partial messages to be received. SoftwareSerial.begin() needs the isrbuffer 10 times the rcv buffer.
    [RYLR998.cpp, RYLR998.h, main.cpp]
2025-01-18 removed some debug prints
2025-01-19 Fixed bogus error due to leftover buffer data
    [RYLR998.cpp]
2025-02-05 Mostly changes to the box and board design
    [DeliveryBoxReporter with LoRa-Bottom.stl, DeliveryBoxReporter with LoRa-Top.stl, LoRa-to-MQTT-Translator-Bottom.stl, LoRa-to-MQTT-Translator-Top.stl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]
2025-02-11 Changes to the enclosures, presentation, and code
    [DeliveryBoxReporter with LoRa-Left-Bottom.stl, DeliveryBoxReporter with LoRa-Left-Top.stl, LoRa-to-MQTT-Translator-Bottom.stl, LoRa-to-MQTT-Translator-Top.stl, LoRa-to-MQTT-disp-Bottom.stl, LoRa-to-MQTT-disp-Top.stl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]
2025-02-12 Pulled code to enable and disable LORA radio into a separate function
    [delivery-box-reporter-lora.kicad_sch]
2025-02-14 Updated presentation
    [LoRa-to-MQTT-disp-Top.stl]
2025-02-17 Case and presentation updates
2025-03-05 Small changes to the LoRa power circuit.
    [DeliveryBoxReporter with LoRa-Bottom.stl, LoRa-to-MQTT-Translator-Bottom.stl, LoRa-to-MQTT-Translator-Top.stl, delivery-box-reporter-lora.kicad_pcb, delivery-box-reporter-lora.kicad_sch, displayHolder.FCStd, displayHolder.stl, untitled.kicad_sch]
